jainamtated-11/CNC-Spindle-Prognosis-and-Predictive-Maintenance-for-Zero-Unplanned-Downtime/results/Calibrometer_User-Interface.png

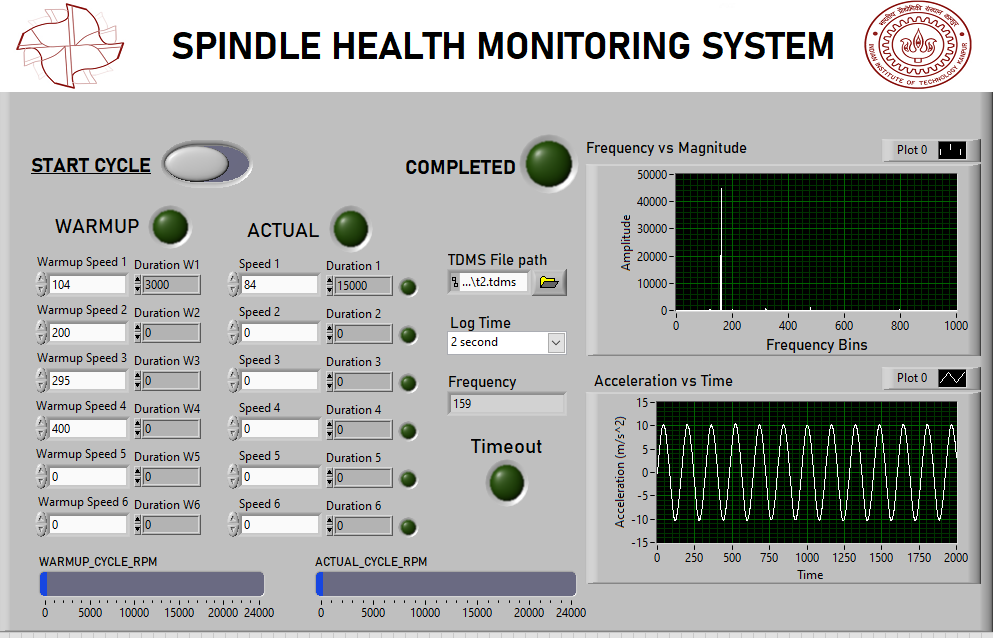
results/Calibrometer_User-Interface.png
