jainamtated-11/CNC-Spindle-Prognosis-and-Predictive-Maintenance-for-Zero-Unplanned-Downtime/schematics/RaspberryPi_Arduino.pdf

## Buffer Amplifier

LM317 | low-impedence-output

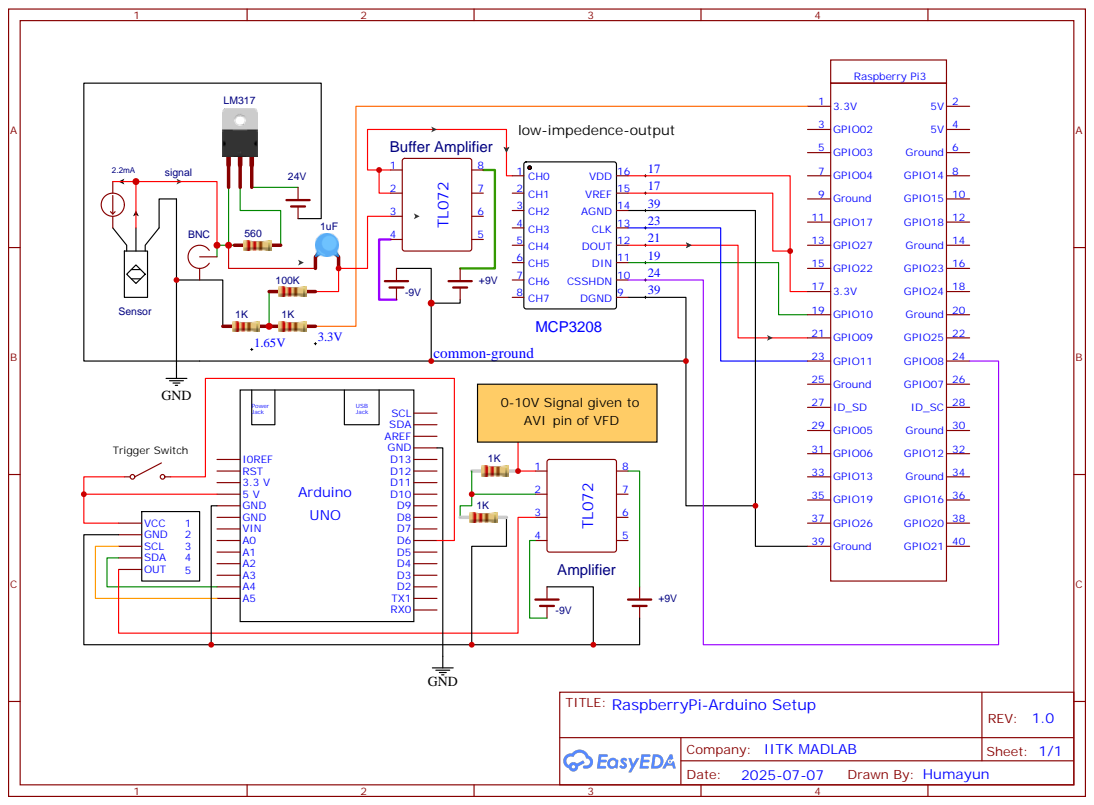
[picture p16: page 1]

0-10V Signal given to
AVI pin of VFD

TITLE: RaspberryPi-Arduino Setup
