jainamtated-11/CNC-Spindle-Prognosis-and-Predictive-Maintenance-for-Zero-Unplanned-Downtime/schematics/LabVIEW_cRIO.pdf

NI 9375 | NI 9263 | NI 9234

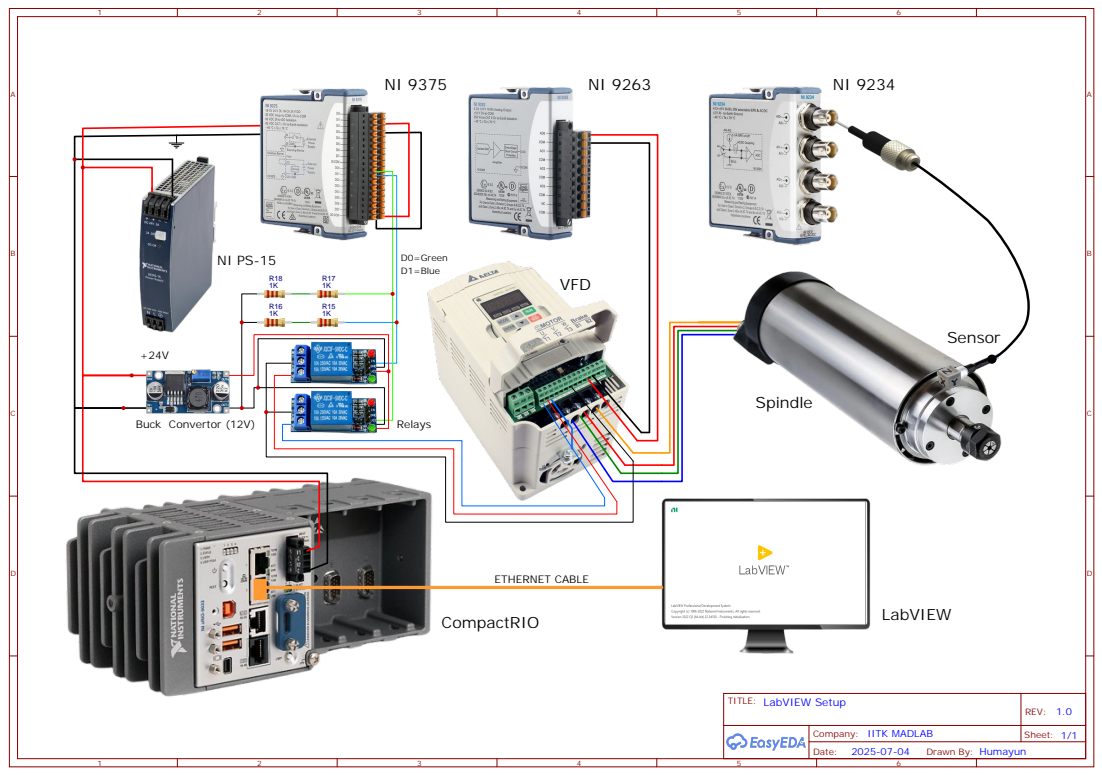
[picture p17: page 1]
